greatscottgadgets/amalthea-hardware/README.md

# amalthea-hardware

Amalthea is an experimental experimental SDR platform implemented as a mezzanine add-on for [Cynthion](https://greatscottgadgets.com/cynthion/).

Gateware and host software may be found in the [amalthea repository](https://github.com/greatscottgadgets/amalthea).
