greatscottgadgets/amalthea-hardware/amalthea.kicad_pcb

## KiCad design amalthea.kicad_pcb (2023-03-27)

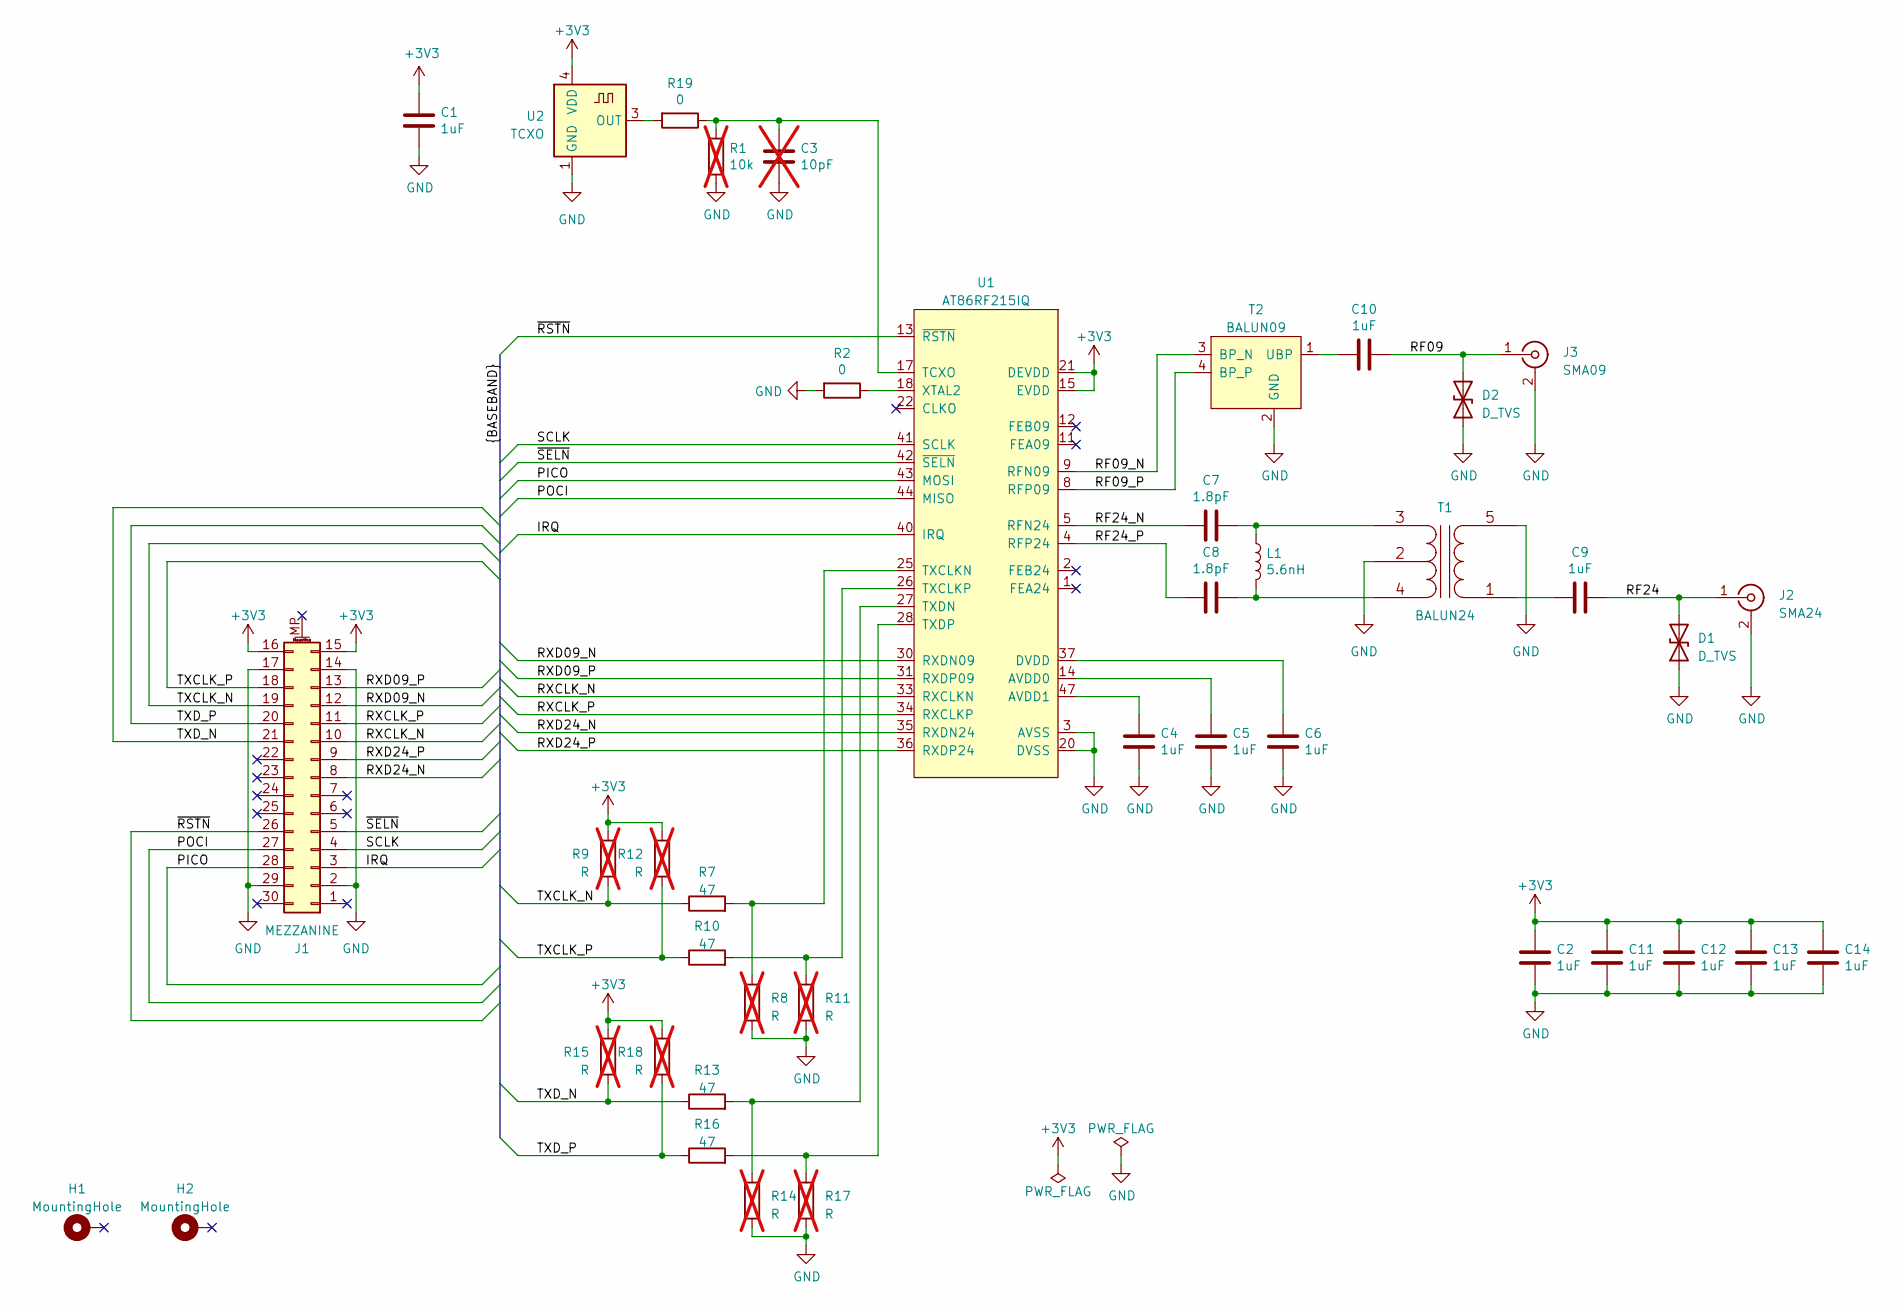
[picture p1: schematic amalthea.kicad_sch]

Parts:
C1, C2, C4, C5, C6, C9, C10, C11, C12, C13, C14: 1uF; C_0402_1005Metric; Manufacturer Part Number CL05A105KA5NQNC; JLCPCB Part Number C52923
C3: 10pF; C_0402_1005Metric; not fitted
C7, C8: 1.8pF; C_0402_1005Metric; Manufacturer Part Number GJM1555C1H1R8BB01D; JLCPCB Part Number C76902
D1, D2: D_TVS; DFN1006-2; Manufacturer Part Number ESDSLC5V0LBS; JLCPCB Part Number C2762105
H1, H2: MountingHole; MountingHole_2.2mm_M2_Pad_Via
J1: MEZZANINE; Amphenol_10132797-03; Manufacturer Part Number 10132797-033100LF; JLCPCB Part Number n/a
J2: SMA24; SMA-EDGE; Manufacturer Part Number CONSMA003.062; JLCPCB Part Number n/a
J3: SMA09; SMA-EDGE; Manufacturer Part Number CONSMA003.062; JLCPCB Part Number n/a
L1: 5.6nH; L_0402_1005Metric; Manufacturer Part Number MLG1005S5N6CT000; JLCPCB Part Number C275295
R1: 10k; R_0402_1005Metric; not fitted
R2, R19: 0; R_0402_1005Metric; Manufacturer Part Number 0402WGF0000TCE; JLCPCB Part Number C17168
R7, R10, R13, R16: 47; R_0402_1005Metric; Manufacturer Part Number 0402WGF470JTCE; JLCPCB Part Number C25118
R8, R9, R11, R12, R14, R15, R17, R18: R; R_0402_1005Metric; not fitted
T1: BALUN24; Balun_Johanson_0896BM15A0001; Manufacturer Part Number 2450FB15A050; JLCPCB Part Number C5244324
T2: BALUN09; Balun_Johanson_0896BM15A0001; Manufacturer Part Number 0896BM15E0025; JLCPCB Part Number C3304914
U1: AT86RF215IQ; QFN-48-1EP_7x7mm_P0.5mm_EP5.6x5.6mm_ThermalVias; Manufacturer Part Number AT86RF215IQ-ZU; JLCPCB Part Number C1558327
U2: TCXO; Crystal_SMD_2016-4Pin_2.0x1.6mm; Manufacturer Part Number 6TG2600001; JLCPCB Part Number C5121629

Connections:
+3V3: C1.1, C2.1, C11.1, C12.1, C13.1, C14.1, J1.15, J1.16, R9.2, R12.2, R15.2, R18.2, U1.15 (EVDD), U1.21 (DEVDD), U1.29 (DEVDD), U1.39 (DEVDD), U1.46 (EVDD), U2.4 (VDD)
/IRQ: J1.3, U1.40 (IRQ)
/PICO: J1.28, U1.43 (MOSI)
/POCI: J1.27, U1.44 (MISO)
/RF09: C10.1, D2.2 (A2), J3.1 (In)
/RF09_N: T2.3 (BP_N), U1.9 (RFN09)
/RF09_P: T2.4 (BP_P), U1.8 (RFP09)
/RF24: C9.1, D1.2 (A2), J2.1 (In)
/RF24_N: C7.2, U1.5 (RFN24)
/RF24_P: C8.1, U1.4 (RFP24)
/RXCLK_N: J1.10, U1.33 (RXCLKN)
/RXCLK_P: J1.11, U1.34 (RXCLKP)
/RXD09_N: J1.12, U1.30 (RXDN09)
/RXD09_P: J1.13, U1.31 (RXDP09)
/RXD24_N: J1.8, U1.35 (RXDN24)
/RXD24_P: J1.9, U1.36 (RXDP24)
/SCLK: J1.4, U1.41 (SCLK)
/TXCLK_N: J1.19, R7.1, R9.1
/TXCLK_P: J1.18, R10.1, R12.1
/TXD_N: J1.21, R13.1, R15.1
/TXD_P: J1.20, R16.1, R18.1
/~RSTN: J1.26, U1.13 (~RSTN)
/~SELN: J1.5, U1.42 (~SELN)
GND: C1.2, C2.2, C3.2, C4.2, C5.2, C6.2, C11.2, C12.2, C13.2, C14.2, D1.1 (A1), D2.1 (A1), J1.2, J1.14, J1.17, J1.29, J2.2 (Ext), J3.2 (Ext), R1.2, R2.2, R8.1, R11.1, R14.1, R17.1, T1.2 (PM), T1.5 (S2), T2.2 (GND), T2.5 (GND), T2.6 (GND), U1.3 (AVSS), U1.6 (AVSS), U1.7 (AVSS), U1.10 (AVSS), U1.16 (AVSS), U1.19 (AVSS), U1.20 (DVSS), U1.23 (DVSS), U1.24 (DVSS), U1.32 (DVSS), U1.38 (DVSS), U1.45 (AVSS), U1.48 (AVSS), U1.49 (AVSS), U2.1 (GND), U2.2 (GND)
unnamed: C7.1, L1.1, T1.3 (PR1)
unnamed: C8.2, L1.2, T1.4 (PR2)
unnamed: C9.2, T1.1 (S1)
unnamed: C10.2, T2.1 (UBP)
unnamed: C5.1, U1.14 (AVDD0)
unnamed: C4.1, U1.47 (AVDD1)
unnamed: C6.1, U1.37 (DVDD)
unnamed: C3.1, R1.1, R19.1, U1.17 (TCXO)
unnamed: R7.2, R8.2, U1.25 (TXCLKN)
unnamed: R10.2, R11.2, U1.26 (TXCLKP)
unnamed: R13.2, R14.2, U1.27 (TXDN)
unnamed: R16.2, R17.2, U1.28 (TXDP)
unnamed: R2.1, U1.18 (XTAL2)
unnamed: R19.2, U2.3 (OUT)

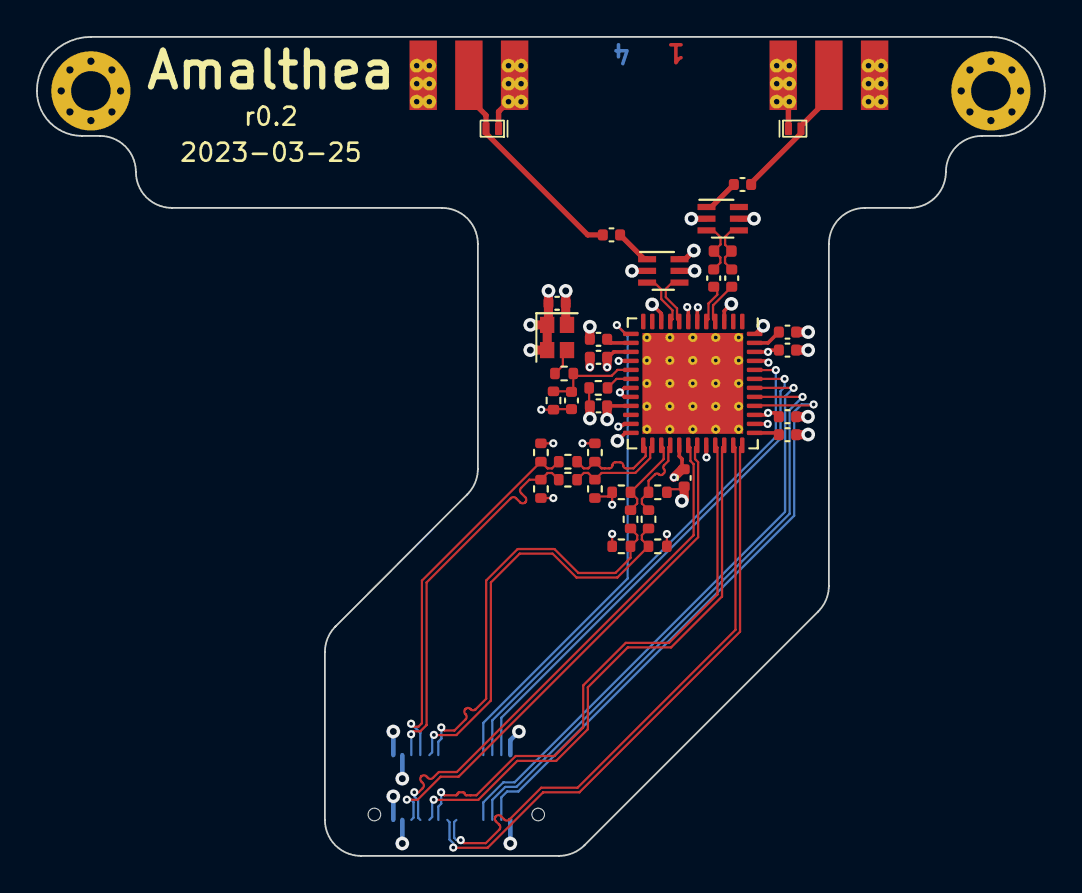
[picture p2: board amalthea.kicad_pcb from above]

Board: 4 copper layers, 56.0 x 45.5 mm, 41 parts (1 on the bottom side), 38 nets.
