greatscottgadgets/amalthea-hardware/(notices)

Notices in the files:
amalthea.kicad_pcb:
Copyright 2020-2023 Great Scott Gadgets
Licensed under the CERN-OHL-P v2
